vicman-6174/Killswitch-mini/robot.md

# Robot: Killswitch

## Descripción

Este robot fue diseñado específicamente para competir en la categoría MiniSumo del All Japan Robot Sumo Tournament 2026.

El diseño prioriza:

- rapidez
- aceleración
- estabilidad
- facilidad de mantenimiento
- estrategias configurables

## Características principales

- PCB propia Xmotion V3
- 5 sensores IR para detección del oponente
- 2 sensores QTR para detección del borde
- Motores N20 de 400 RPM
- Alimentación mediante batería LiPo 3S
- Navaja frontal
- Chasis impreso en 3D con placa de latón de 70x48 mm

## Objetivo del diseño

Tener un robot versátil que pueda dar tanto estabilidad en estretegias de búsqueda como velocidad en casos de ataque rápido.
