vicman-6174/Killswitch-mini/(list of files, cad)

Other CAD files:
hardware.md/Killswitch.x_t
