vicman-6174/Killswitch-mini/(commit log)

2026-07-23 Create sensores
2026-07-23 Create CAD
2026-07-23 CAD Chasis Killswitch
    [Killswitch.x_t]
2026-07-23 Update CAD
2026-07-23 Update sensores
2026-07-26 Improve image presentation in CAD documentation
    Updated image formatting and added a caption for clarity.
2026-07-26 Adjust image width in CAD.md
    Updated image width in CAD.md for better display.
2026-07-26 Update motor specifications in CAD.md
